Kibabalu/Pico_LoRa/README.md

# Pico LoRa Node

LoRa Node based on Raspberry Pi Pico and LoRa board RFM95

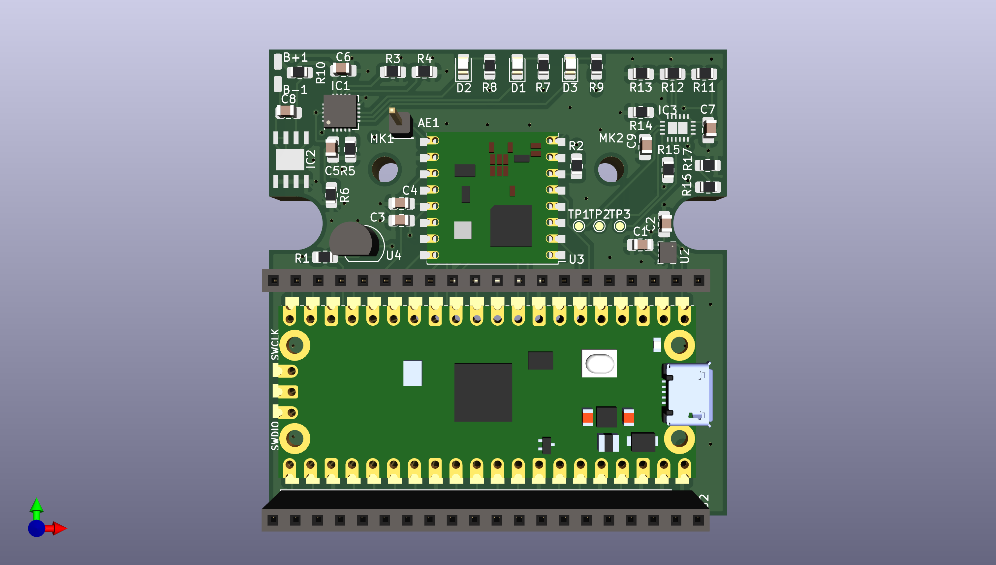
[picture p1: Pico_LoRa.png]
Board rendering


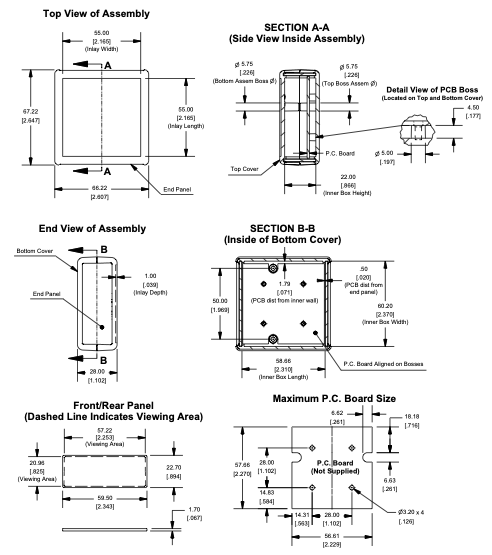
[picture p2: 1593K.png]
Enclosure
