Kibabalu/Pico_LoRa/Pico_LoRa.csv

Source: | /Users/frankkirschbaum/Documents/KiCad/projects/pico_lora/Pico_LoRa.kicad_sch
Date: | Sonntag, 30. Januar 2022 um 19:37:48
Tool: | Eeschema (6.0.1-0)
Generator: | /Applications/KiCad/KiCad.app/Contents/SharedSupport/plugins/bom_csv_grouped_by_value.py
Component Count: | 44
Individual Components:
Item | Qty | Reference(s) | Value | LibPart | Footprint | Datasheet
 |  | AE1 | Antenna | Device:Antenna | Connector_PinHeader_2.54mm:PinHeader_1x01_P2.54mm_Vertical | ~
 |  | B+1 | B+ | Connector_Generic:Conn_01x01 | Connector_Wire:SolderWirePad_1x01_SMD_1x2mm | ~
 |  | B-1 | B- | Connector_Generic:Conn_01x01 | Connector_Wire:SolderWirePad_1x01_SMD_1x2mm | ~
 |  | C1 | 220n | Device:C_Small | Capacitor_SMD:C_0805_2012Metric_Pad1.18x1.45mm_HandSolder | ~
 |  | C2 | 1n | Device:C_Small | Capacitor_SMD:C_0805_2012Metric_Pad1.18x1.45mm_HandSolder | ~
 |  | C3 | 4u7 | Device:C_Small | Capacitor_SMD:C_0805_2012Metric_Pad1.18x1.45mm_HandSolder | ~
 |  | C4 | 100n | Device:C_Small | Capacitor_SMD:C_0805_2012Metric_Pad1.18x1.45mm_HandSolder | ~
 |  | C5 | 10u | Device:C_Small | Capacitor_SMD:C_0805_2012Metric_Pad1.18x1.45mm_HandSolder | ~
 |  | C6 | 4u7 | Device:C_Small | Capacitor_SMD:C_0805_2012Metric_Pad1.18x1.45mm_HandSolder | ~
 |  | C7 | 4u7 | Device:C_Small | Capacitor_SMD:C_0805_2012Metric_Pad1.18x1.45mm_HandSolder | ~
 |  | C8 | 100n | Device:C_Small | Capacitor_SMD:C_0805_2012Metric_Pad1.18x1.45mm_HandSolder | ~
 |  | C9 | 1n5 | Device:C_Small | Capacitor_SMD:C_0805_2012Metric_Pad1.18x1.45mm_HandSolder | ~
 |  | D1 | LED | Device:LED_Small | LED_SMD:LED_0805_2012Metric_Pad1.15x1.40mm_HandSolder | ~
 |  | D2 | LED | Device:LED_Small | LED_SMD:LED_0805_2012Metric_Pad1.15x1.40mm_HandSolder | ~
 |  | D3 | LED | Device:LED_Small | LED_SMD:LED_0805_2012Metric_Pad1.15x1.40mm_HandSolder | ~
 |  | IC1 | MCP73871 | Battery_Management:MCP73871-1CC | Package_DFN_QFN:QFN-20-1EP_4x4mm_P0.5mm_EP2.5x2.5mm | http://www.mouser.com/ds/2/268/22090a-52174.pdf
 |  | IC2 | XB8089D | Xysemi:XB8089D | XB8089D:XB8089D
 |  | IC3 | TPS25940x | TI_TPS25940x:TPS25940x | TI_WQFN_20_EP_2.8x3.8:TI_WQFN_20_EP
 |  | J1 | Conn | Connector:Conn_01x20_Female | Connector_PinSocket_2.54mm:PinSocket_1x20_P2.54mm_Vertical | ~
 |  | J2 | Conn | Connector:Conn_01x20_Female | Connector_PinSocket_2.54mm:PinSocket_1x20_P2.54mm_Vertical | ~
 |  | R1 | 10k | Device:R_Small | Resistor_SMD:R_0805_2012Metric_Pad1.20x1.40mm_HandSolder | ~
 |  | R2 | 4k7 | Device:R_Small | Resistor_SMD:R_0805_2012Metric_Pad1.20x1.40mm_HandSolder | ~
 |  | R3 | 1k | Device:R_Small | Resistor_SMD:R_0805_2012Metric_Pad1.20x1.40mm_HandSolder | ~
 |  | R4 | 100k | Device:R_Small | Resistor_SMD:R_0805_2012Metric_Pad1.20x1.40mm_HandSolder | ~
 |  | R5 | 10k | Device:R_Small | Resistor_SMD:R_0805_2012Metric_Pad1.20x1.40mm_HandSolder | ~
 |  | R6 | 100k | Device:R_Small | Resistor_SMD:R_0805_2012Metric_Pad1.20x1.40mm_HandSolder | ~
 |  | R7 | 470R | Device:R_Small | Resistor_SMD:R_0805_2012Metric_Pad1.20x1.40mm_HandSolder | ~
 |  | R8 | 470R | Device:R_Small | Resistor_SMD:R_0805_2012Metric_Pad1.20x1.40mm_HandSolder | ~
 |  | R9 | 470R | Device:R_Small | Resistor_SMD:R_0805_2012Metric_Pad1.20x1.40mm_HandSolder | ~
 |  | R10 | 1k | Device:R_Small | Resistor_SMD:R_0805_2012Metric_Pad1.20x1.40mm_HandSolder | ~
 |  | R11 | 120k | Device:R_Small | Resistor_SMD:R_0805_2012Metric_Pad1.20x1.40mm_HandSolder | ~
 |  | R12 | 27K2 | Device:R_Small | Resistor_SMD:R_0805_2012Metric_Pad1.20x1.40mm_HandSolder | ~
 |  | R13 | 33K2 | Device:R_Small | Resistor_SMD:R_0805_2012Metric_Pad1.20x1.40mm_HandSolder | ~
 |  | R14 | 47K | Device:R_Small | Resistor_SMD:R_0805_2012Metric_Pad1.20x1.40mm_HandSolder | ~
 |  | R15 | 10k | Device:R_Small | Resistor_SMD:R_0805_2012Metric_Pad1.20x1.40mm_HandSolder | ~
 |  | R16 | 470k | Device:R_Small | Resistor_SMD:R_0805_2012Metric_Pad1.20x1.40mm_HandSolder | ~
 |  | R17 | 220k | Device:R_Small | Resistor_SMD:R_0805_2012Metric_Pad1.20x1.40mm_HandSolder | ~
 |  | TP1 | TP | Connector:TestPoint | TestPoint:TestPoint_Pad_D1.0mm | ~
 |  | TP2 | TP | Connector:TestPoint | TestPoint:TestPoint_Pad_D1.0mm | ~
 |  | TP3 | TP | Connector:TestPoint | TestPoint:TestPoint_Pad_D1.0mm | ~
 |  | U1 | Pico | MCU_RaspberryPi_and_Boards:Pico | RPi_Pico:RPi_Pico_SMD_TH
 |  | U2 | BMP280 | Sensor_Pressure:BMP280 | Package_LGA:Bosch_LGA-8_2x2.5mm_P0.65mm_ClockwisePinNumbering | https://ae-bst.resource.bosch.com/media/_tech/media/datasheets/BST-BMP280-DS001.pdf
 |  | U3 | RFM95W-868S2 | RF_Module:RFM95W-868S2 | RF_Module:HOPERF_RFM9XW_SMD | https://www.hoperf.com/data/upload/portal/20181127/5bfcbea20e9ef.pdf
 |  | U4 | DS18B20 | Sensor_Temperature:DS18B20 | Package_TO_SOT_THT:TO-92_Inline | http://datasheets.maximintegrated.com/en/ds/DS18B20.pdf
Collated Components:
Item | Qty | Reference(s) | Value | LibPart | Footprint | Datasheet
1 | 1 | AE1 | Antenna | Device:Antenna | Connector_PinHeader_2.54mm:PinHeader_1x01_P2.54mm_Vertical | ~
2 | 1 | B+1 | B+ | Connector_Generic:Conn_01x01 | Connector_Wire:SolderWirePad_1x01_SMD_1x2mm | ~
3 | 1 | B-1 | B- | Connector_Generic:Conn_01x01 | Connector_Wire:SolderWirePad_1x01_SMD_1x2mm | ~
4 | 1 | C1 | 220n | Device:C_Small | Capacitor_SMD:C_0805_2012Metric_Pad1.18x1.45mm_HandSolder | ~
5 | 1 | C2 | 1n | Device:C_Small | Capacitor_SMD:C_0805_2012Metric_Pad1.18x1.45mm_HandSolder | ~
6 | 3 | C3, C6, C7 | 4u7 | Device:C_Small | Capacitor_SMD:C_0805_2012Metric_Pad1.18x1.45mm_HandSolder | ~
7 | 2 | C4, C8 | 100n | Device:C_Small | Capacitor_SMD:C_0805_2012Metric_Pad1.18x1.45mm_HandSolder | ~
8 | 1 | C5 | 10u | Device:C_Small | Capacitor_SMD:C_0805_2012Metric_Pad1.18x1.45mm_HandSolder | ~
9 | 1 | C9 | 1n5 | Device:C_Small | Capacitor_SMD:C_0805_2012Metric_Pad1.18x1.45mm_HandSolder | ~
10 | 3 | D1, D2, D3 | LED | Device:LED_Small | LED_SMD:LED_0805_2012Metric_Pad1.15x1.40mm_HandSolder | ~
11 | 1 | IC1 | MCP73871 | Battery_Management:MCP73871-1CC | Package_DFN_QFN:QFN-20-1EP_4x4mm_P0.5mm_EP2.5x2.5mm | http://www.mouser.com/ds/2/268/22090a-52174.pdf
12 | 1 | IC2 | XB8089D | Xysemi:XB8089D | XB8089D:XB8089D
13 | 1 | IC3 | TPS25940x | TI_TPS25940x:TPS25940x | TI_WQFN_20_EP_2.8x3.8:TI_WQFN_20_EP
14 | 2 | J1, J2 | Conn | Connector:Conn_01x20_Female | Connector_PinSocket_2.54mm:PinSocket_1x20_P2.54mm_Vertical | ~
15 | 3 | R1, R5, R15 | 10k | Device:R_Small | Resistor_SMD:R_0805_2012Metric_Pad1.20x1.40mm_HandSolder | ~
16 | 1 | R2 | 4k7 | Device:R_Small | Resistor_SMD:R_0805_2012Metric_Pad1.20x1.40mm_HandSolder | ~
17 | 2 | R3, R10 | 1k | Device:R_Small | Resistor_SMD:R_0805_2012Metric_Pad1.20x1.40mm_HandSolder | ~
18 | 2 | R4, R6 | 100k | Device:R_Small | Resistor_SMD:R_0805_2012Metric_Pad1.20x1.40mm_HandSolder | ~
19 | 3 | R7, R8, R9 | 470R | Device:R_Small | Resistor_SMD:R_0805_2012Metric_Pad1.20x1.40mm_HandSolder | ~
20 | 1 | R11 | 120k | Device:R_Small | Resistor_SMD:R_0805_2012Metric_Pad1.20x1.40mm_HandSolder | ~
21 | 1 | R12 | 27K2 | Device:R_Small | Resistor_SMD:R_0805_2012Metric_Pad1.20x1.40mm_HandSolder | ~
22 | 1 | R13 | 33K2 | Device:R_Small | Resistor_SMD:R_0805_2012Metric_Pad1.20x1.40mm_HandSolder | ~
23 | 1 | R14 | 47K | Device:R_Small | Resistor_SMD:R_0805_2012Metric_Pad1.20x1.40mm_HandSolder | ~
24 | 1 | R16 | 470k | Device:R_Small | Resistor_SMD:R_0805_2012Metric_Pad1.20x1.40mm_HandSolder | ~
25 | 1 | R17 | 220k | Device:R_Small | Resistor_SMD:R_0805_2012Metric_Pad1.20x1.40mm_HandSolder | ~
26 | 3 | TP1, TP2, TP3 | TP | Connector:TestPoint | TestPoint:TestPoint_Pad_D1.0mm | ~
27 | 1 | U1 | Pico | MCU_RaspberryPi_and_Boards:Pico | RPi_Pico:RPi_Pico_SMD_TH
28 | 1 | U2 | BMP280 | Sensor_Pressure:BMP280 | Package_LGA:Bosch_LGA-8_2x2.5mm_P0.65mm_ClockwisePinNumbering | https://ae-bst.resource.bosch.com/media/_tech/media/datasheets/BST-BMP280-DS001.pdf
29 | 1 | U3 | RFM95W-868S2 | RF_Module:RFM95W-868S2 | RF_Module:HOPERF_RFM9XW_SMD | https://www.hoperf.com/data/upload/portal/20181127/5bfcbea20e9ef.pdf
30 | 1 | U4 | DS18B20 | Sensor_Temperature:DS18B20 | Package_TO_SOT_THT:TO-92_Inline | http://datasheets.maximintegrated.com/en/ds/DS18B20.pdf
