Kibabalu/Pico_LoRa/Pico_LoRa-Assembly.pdf

A

A

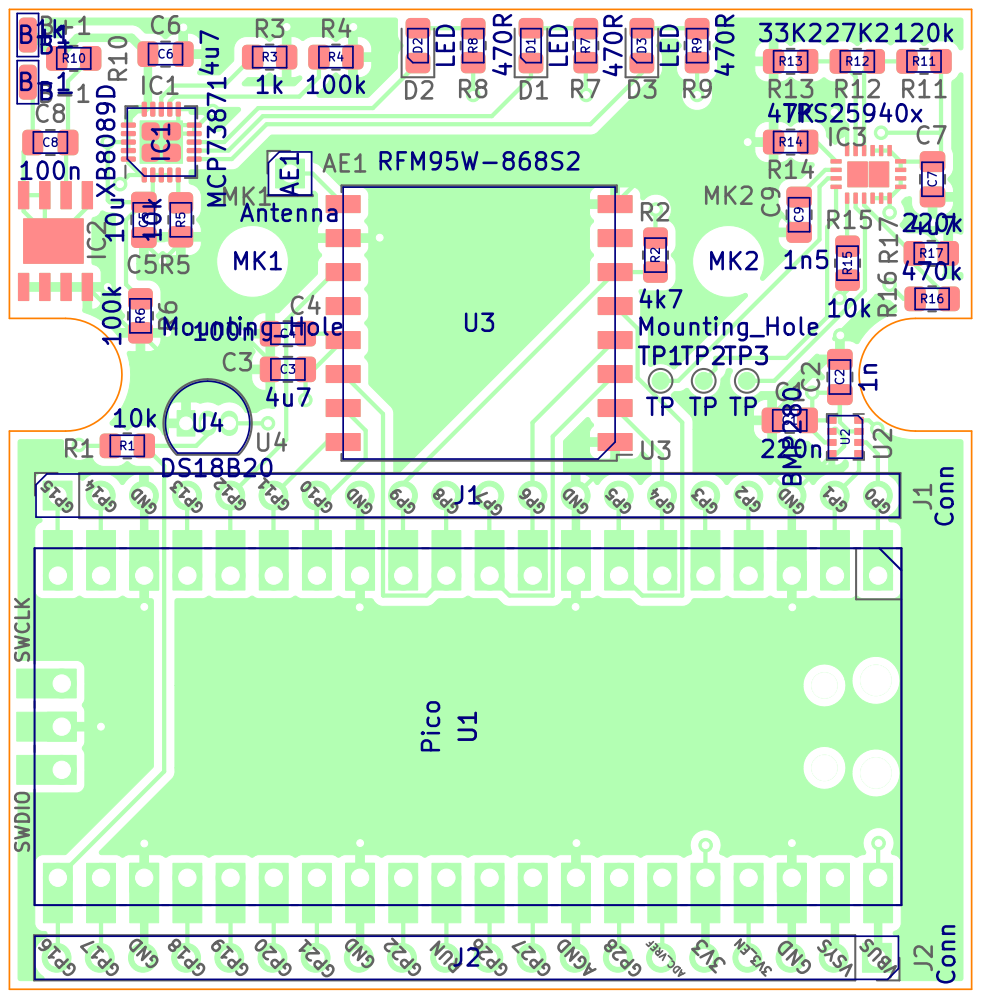
[picture p3: page 1]

TP1 Pico U¹ Antenna AE¹

AISLER Project ID: JIEXEYEN

Frank Kirschbaum, Hohenheimer Straße 71A, 70184 Stuttgart
Cherrytree
Sheet: Assembly
File: Pico_LoRa.kicad_pcb
Id: 1/1 Title: Raspberry Pi Pico LoRa Node

1 | 2 | 3 | 4 | 5

A

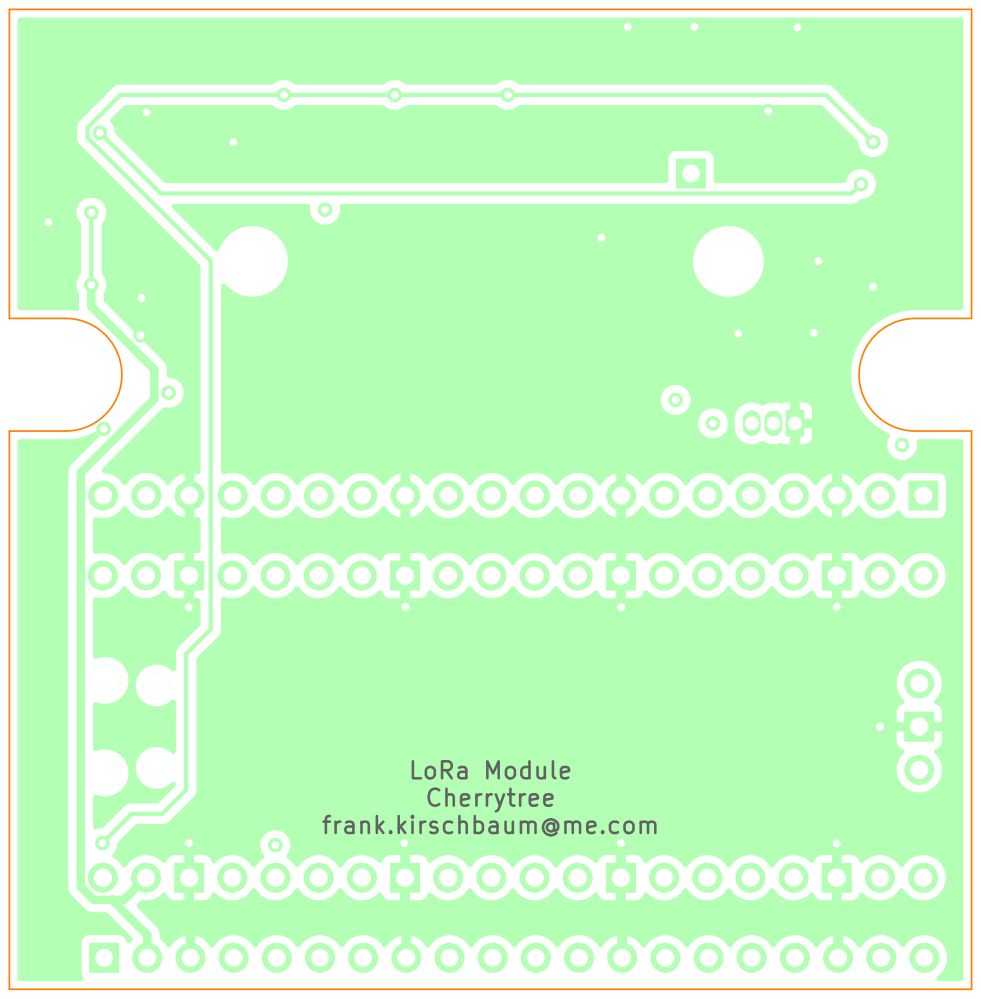
[picture p4: page 2]
D Date: 2022-01-29 KiCad E.D.A. kicad (6.0.1-0) Size: A; Rev: 1.1

LoRa Module Cherrytree

frank.kirschbaum@me.com

AISLER Project ID: JIEXEYEN

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
