Kibabalu/Pico_LoRa/(list of files, drawings)

Other design files:
Pico_LoRa.dsn
