Kibabalu/Pico_LoRa/Pico_LoRa.kicad_pcb

## KiCad design Pico_LoRa.kicad_pcb (2022-02-11)

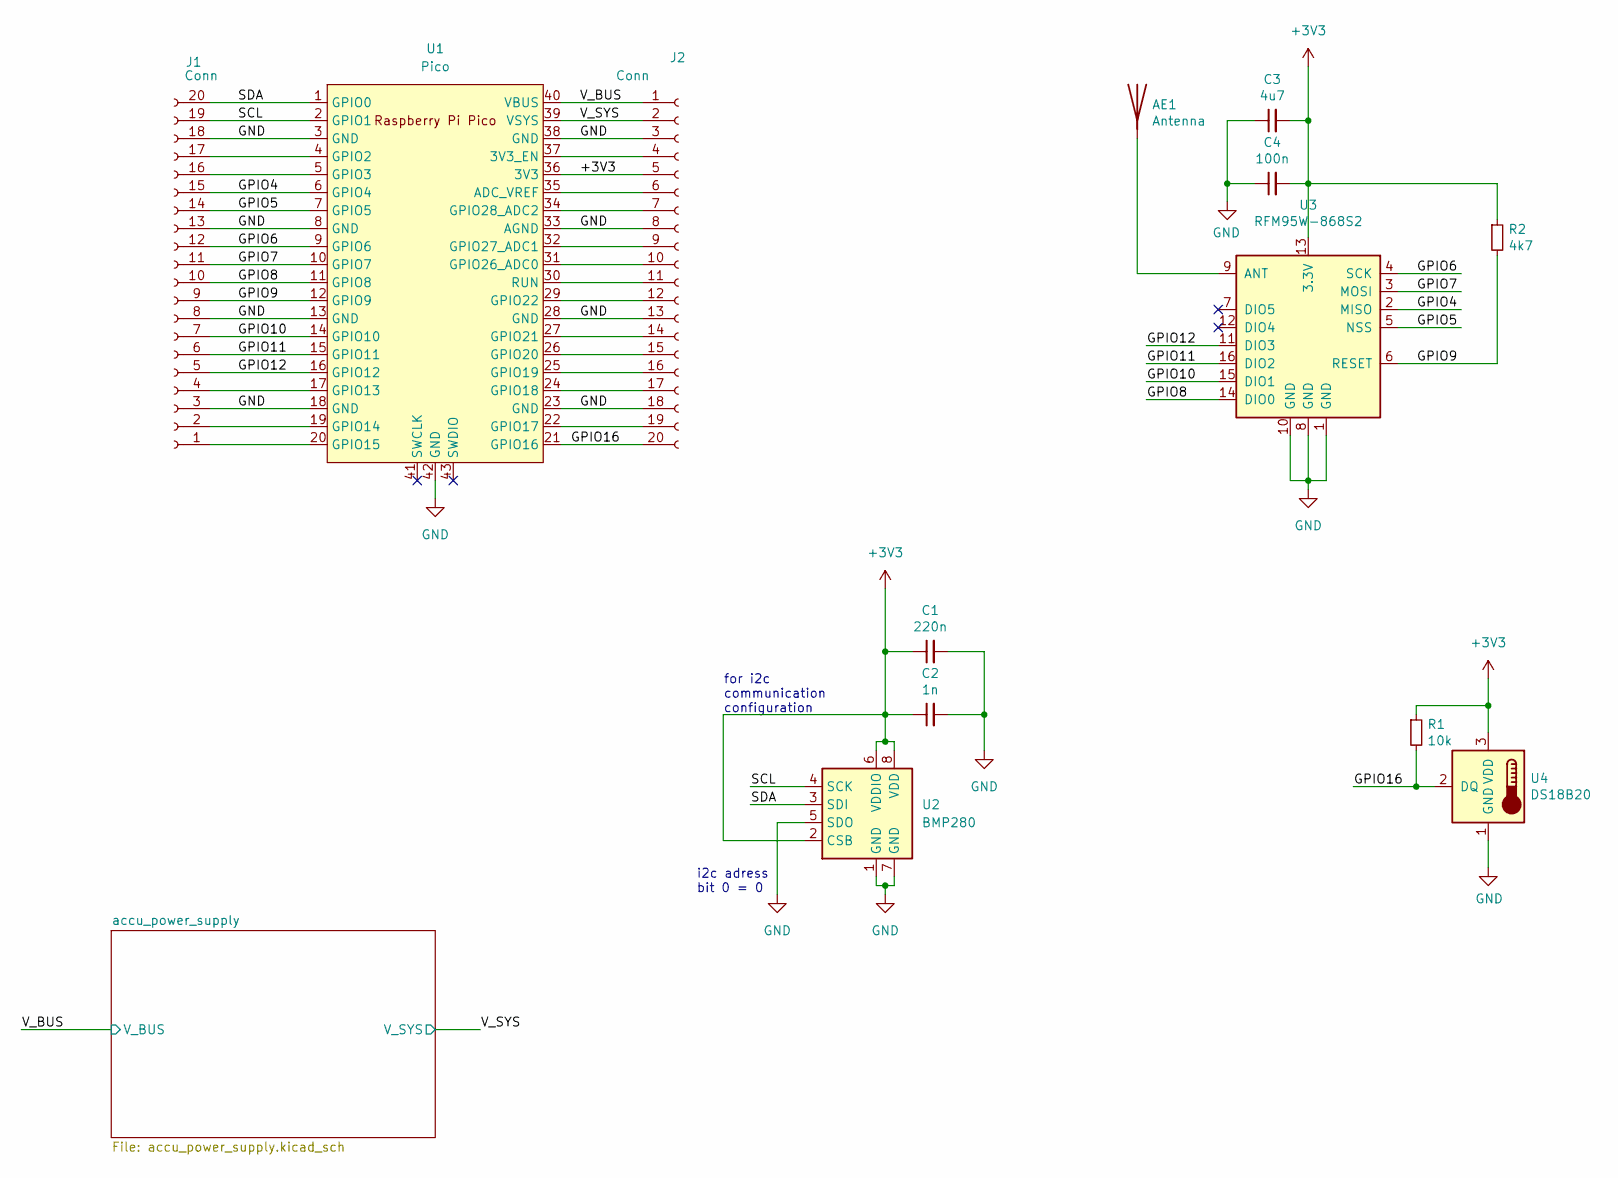
[picture p5: schematic Pico_LoRa.kicad_sch, Raspberry Pi Pico LoRa Node]

Parts:
AE1: Antenna; PinHeader_1x01_P2.54mm_Vertical
C1: 220n; C_0805_2012Metric_Pad1.18x1.45mm_HandSolder
C2: 1n; C_0805_2012Metric_Pad1.18x1.45mm_HandSolder
C3: 4u7; C_0805_2012Metric_Pad1.18x1.45mm_HandSolder
C4: 100n; C_0805_2012Metric_Pad1.18x1.45mm_HandSolder
J1, J2: Conn; PinSocket_1x20_P2.54mm_Vertical
R1: 10k; R_0805_2012Metric_Pad1.20x1.40mm_HandSolder
R2: 4k7; R_0805_2012Metric_Pad1.20x1.40mm_HandSolder
U1: Pico; RPi_Pico_SMD_TH
U2: BMP280; Bosch_LGA-8_2x2.5mm_P0.65mm_ClockwisePinNumbering
U3: RFM95W-868S2; HOPERF_RFM9XW_SMD
U4: DS18B20; TO-92_Inline

Connections:
+3V3: C1.1, C2.1, C3.2, C4.2, J2.5, R1.1, R2.1, U1.36 (3V3), U2.2 (CSB), U2.6 (VDDIO), U2.8 (VDD), U3.13 (3.3V), U4.3 (VDD)
/GPIO4: J1.15, U1.6 (GPIO4), U3.2 (MISO)
/GPIO5: J1.14, U1.7 (GPIO5), U3.5 (NSS)
/GPIO6: J1.12, U1.9 (GPIO6), U3.4 (SCK)
/GPIO7: J1.11, U1.10 (GPIO7), U3.3 (MOSI)
/GPIO8: J1.10, U1.11 (GPIO8), U3.14 (DIO0)
/GPIO9: J1.9, R2.2, U1.12 (GPIO9), U3.6 (RESET)
/GPIO10: J1.7, U1.14 (GPIO10), U3.15 (DIO1)
/GPIO11: J1.6, U1.15 (GPIO11), U3.16 (DIO2)
/GPIO12: J1.5, U1.16 (GPIO12), U3.11 (DIO3)
/GPIO16: J2.20, R1.2, U1.21 (GPIO16), U4.2 (DQ)
/SCL: J1.19, U1.2 (GPIO1), U2.4 (SCK)
/SDA: J1.20, U1.1 (GPIO0), U2.3 (SDI)
/V_BUS: J2.1, U1.40 (VBUS); also elsewhere on the board
/V_SYS: J2.2, U1.39 (VSYS); also elsewhere on the board
GND: C1.2, C2.2, C3.1, C4.1, J1.3, J1.8, J1.13, J1.18, J2.3, J2.8, J2.13, J2.18, U1.3 (GND), U1.8 (GND), U1.13 (GND), U1.18 (GND), U1.23 (GND), U1.28 (GND), U1.33 (AGND), U1.38 (GND), U1.42 (GND), U2.1 (GND), U2.5 (SDO), U2.7 (GND), U3.1 (GND), U3.8 (GND), U3.10 (GND), U4.1 (GND); also elsewhere on the board
unnamed: AE1.1 (A), U3.9 (ANT)
unnamed: J1.1, U1.20 (GPIO15)
unnamed: J1.2, U1.19 (GPIO14)
unnamed: J1.4, U1.17 (GPIO13)
unnamed: J1.16, U1.5 (GPIO3)
unnamed: J1.17, U1.4 (GPIO2)
unnamed: J2.4, U1.37 (3V3_EN)
unnamed: J2.6, U1.35 (ADC_VREF)
unnamed: J2.7, U1.34 (GPIO28_ADC2)
unnamed: J2.9, U1.32 (GPIO27_ADC1)
unnamed: J2.10, U1.31 (GPIO26_ADC0)
unnamed: J2.11, U1.30 (RUN)
unnamed: J2.12, U1.29 (GPIO22)
unnamed: J2.14, U1.27 (GPIO21)
unnamed: J2.15, U1.26 (GPIO20)
unnamed: J2.16, U1.25 (GPIO19)
unnamed: J2.17, U1.24 (GPIO18)
unnamed: J2.19, U1.22 (GPIO17)

Notes on the sheet:
for i2c communication configuration
i2c adress bit 0 = 0

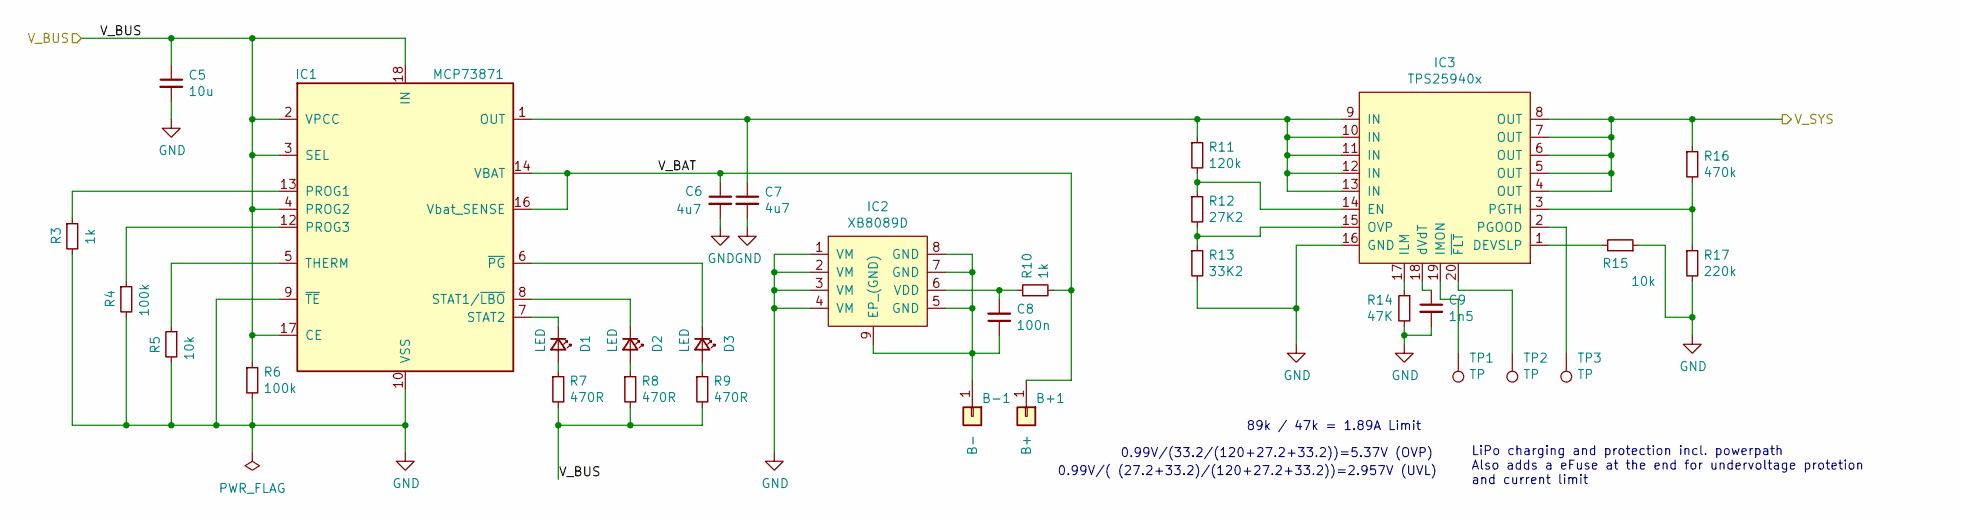
[picture p6: schematic accu_power_supply.kicad_sch, Raspberry Pi Pico LoRa Node]

Parts:
B+1: B+; SolderWirePad_1x01_SMD_1x2mm
B-1: B-; SolderWirePad_1x01_SMD_1x2mm
C5: 10u; C_0805_2012Metric_Pad1.18x1.45mm_HandSolder
C6, C7: 4u7; C_0805_2012Metric_Pad1.18x1.45mm_HandSolder
C8: 100n; C_0805_2012Metric_Pad1.18x1.45mm_HandSolder
C9: 1n5; C_0805_2012Metric_Pad1.18x1.45mm_HandSolder
D1, D2, D3: LED; LED_0805_2012Metric_Pad1.15x1.40mm_HandSolder
IC1: MCP73871; QFN-20-1EP_4x4mm_P0.5mm_EP2.5x2.5mm
IC2: XB8089D
IC3: TPS25940x; TI_WQFN_20_EP
R3, R10: 1k; R_0805_2012Metric_Pad1.20x1.40mm_HandSolder
R4, R6: 100k; R_0805_2012Metric_Pad1.20x1.40mm_HandSolder
R5, R15: 10k; R_0805_2012Metric_Pad1.20x1.40mm_HandSolder
R7, R8, R9: 470R; R_0805_2012Metric_Pad1.20x1.40mm_HandSolder
R11: 120k; R_0805_2012Metric_Pad1.20x1.40mm_HandSolder
R12: 27K2; R_0805_2012Metric_Pad1.20x1.40mm_HandSolder
R13: 33K2; R_0805_2012Metric_Pad1.20x1.40mm_HandSolder
R14: 47K; R_0805_2012Metric_Pad1.20x1.40mm_HandSolder
R16: 470k; R_0805_2012Metric_Pad1.20x1.40mm_HandSolder
R17: 220k; R_0805_2012Metric_Pad1.20x1.40mm_HandSolder
TP1, TP2, TP3: TP; TestPoint_Pad_D1.0mm

Connections:
/V_BUS: C5.1, IC1.2 (VPCC), IC1.3 (SEL), IC1.4 (PROG2), IC1.17 (CE), IC1.18 (IN), IC1.19 (IN), R6.1, R7.2, R8.2, R9.2; also elsewhere on the board
/V_SYS: IC3.4 (OUT), IC3.5 (OUT), IC3.6 (OUT), IC3.7 (OUT), IC3.8 (OUT), R16.1; also elsewhere on the board
/accu_power_supply/V_BAT: B+1.1, C6.1, IC1.14 (VBAT), IC1.15 (VBAT), IC1.16 (Vbat_SENSE), R10.2
GND: C5.2, C6.2, C7.2, C9.2, IC1.9 (~TE), IC1.10 (VSS), IC1.11 (VSS), IC1.21 (VSS), IC2.1 (VM), IC2.2 (VM), IC2.3 (VM), IC2.4 (VM), IC3.16 (GND), R3.2, R4.2, R5.2, R6.2, R13.2, R14.2, R15.1, R17.2; also elsewhere on the board
unnamed: B-1.1, C8.1, IC2.5 (GND), IC2.7 (GND), IC2.8 (GND), IC2.9 (EP_(GND))
unnamed: C7.1, IC1.1 (OUT), IC1.20 (OUT), IC3.9 (IN), IC3.10 (IN), IC3.11 (IN), IC3.12 (IN), IC3.13 (IN), R11.1
unnamed: C8.2, IC2.6 (VDD), R10.1
unnamed: C9.1, IC3.18 (dVdT)
unnamed: D1.1 (K), IC1.7 (STAT2)
unnamed: D1.2 (A), R7.1
unnamed: D2.1 (K), IC1.8 (STAT1/~LBO)
unnamed: D2.2 (A), R8.1
unnamed: D3.1 (K), IC1.6 (~PG)
unnamed: D3.2 (A), R9.1
unnamed: IC1.5 (THERM), R5.1
unnamed: IC1.12 (PROG3), R4.1
unnamed: IC1.13 (PROG1), R3.1
unnamed: IC3.1 (DEVSLP), R15.2
unnamed: IC3.2 (PGOOD), TP3.1
unnamed: IC3.3 (PGTH), R16.2, R17.1
unnamed: IC3.14 (EN), R11.2, R12.1
unnamed: IC3.15 (OVP), R12.2, R13.1
unnamed: IC3.17 (ILM), R14.1
unnamed: IC3.19 (IMON), TP1.1
unnamed: IC3.20 (~FLT), TP2.1

Notes on the sheet:
89k / 47k = 1.89A Limit
LiPo charging and protection incl. powerpath Also adds a eFuse at the end for undervoltage protetion and current limit
0.99V/(33.2/(120+27.2+33.2))=5.37V (OVP)
0.99V/( (27.2+33.2)/(120+27.2+33.2))=2.957V (UVL)

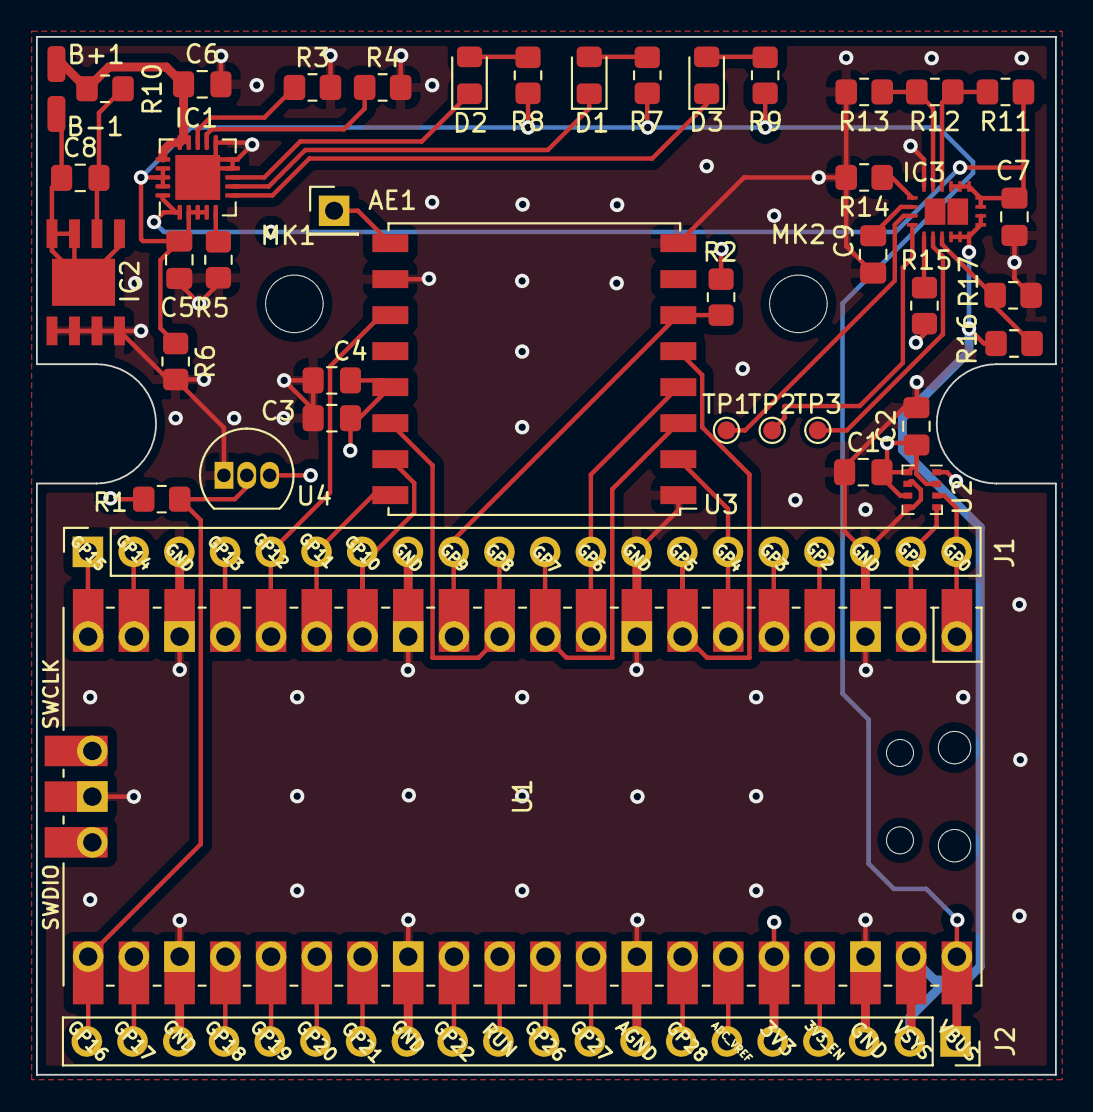
[picture p7: board Pico_LoRa.kicad_pcb from above]

Board: 4 copper layers, 56.6 x 57.7 mm, 46 parts (0 on the bottom side), 56 nets.

Other parts of the board:
MK1, MK2: Mounting_Hole; MountingHole_3.2mm_M3_ISO7380
