Kibabalu/Pico_LoRa/(commit log)

2022-01-31 1st commit of the board ordered by Aisler
    [BOM-Pico_LoRa.csv, Pico_LoRa 3.sch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]
2022-01-31 rendering of the board
2022-01-31 some cleaning
    [Pico_LoRa.sch]
2022-02-06 some more GND vias
    [Pico_LoRa.dsn, Pico_LoRa.kicad_pcb, Pico_LoRa.kicad_sch, accu_power_supply.kicad_sch]
2022-02-11 enclosure pic added
    [Pico_LoRa.kicad_pcb]
